GormR/DomesticSupplySupervision/documentation/cutting_PCB.jpg

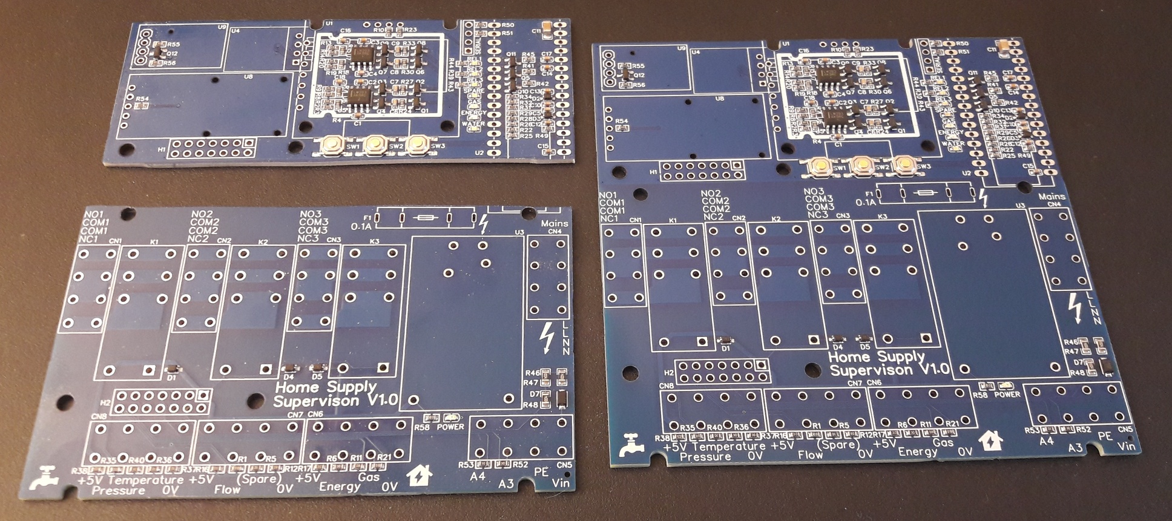
documentation/cutting_PCB.jpg
