GormR/DomesticSupplySupervision/documentation/motor_valve.png

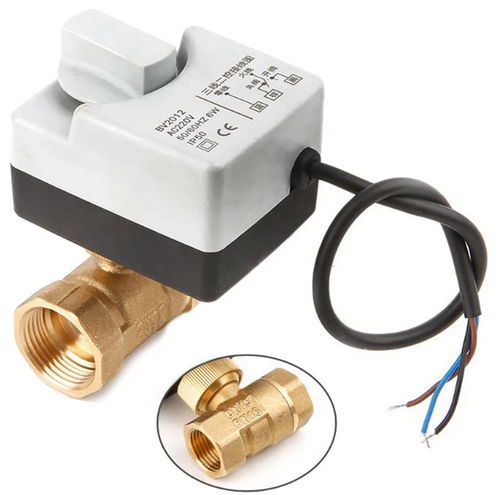
documentation/motor_valve.png
