GormR/DomesticSupplySupervision/documentation/varistor.jpg

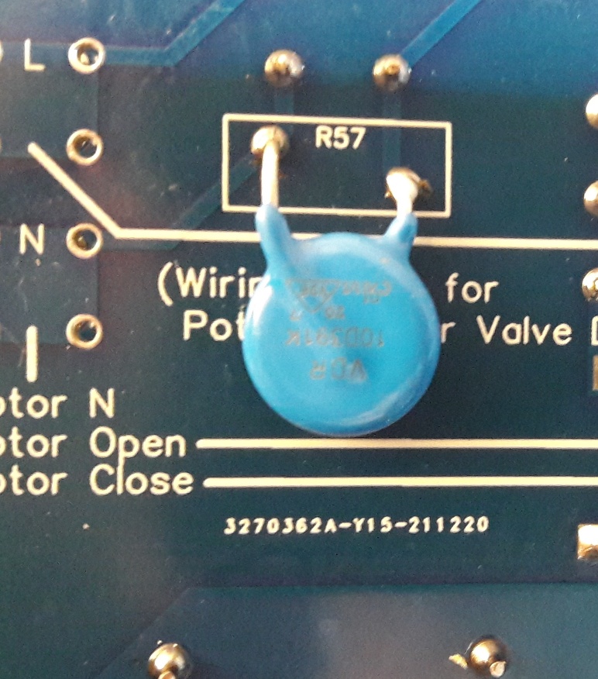
documentation/varistor.jpg
