GormR/DomesticSupplySupervision/documentation/water_flow_meter.png

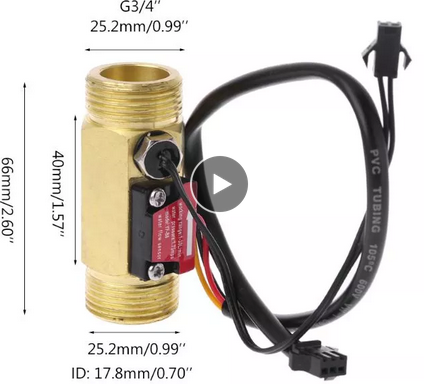
documentation/water_flow_meter.png
