GormR/DomesticSupplySupervision/changelog.txt

V0.0  initial prototype shown in one of the pictures 

V1.0
- first prototype
