GormR/DomesticSupplySupervision/Schematic_Domestic_Supply_Supervision.pdf

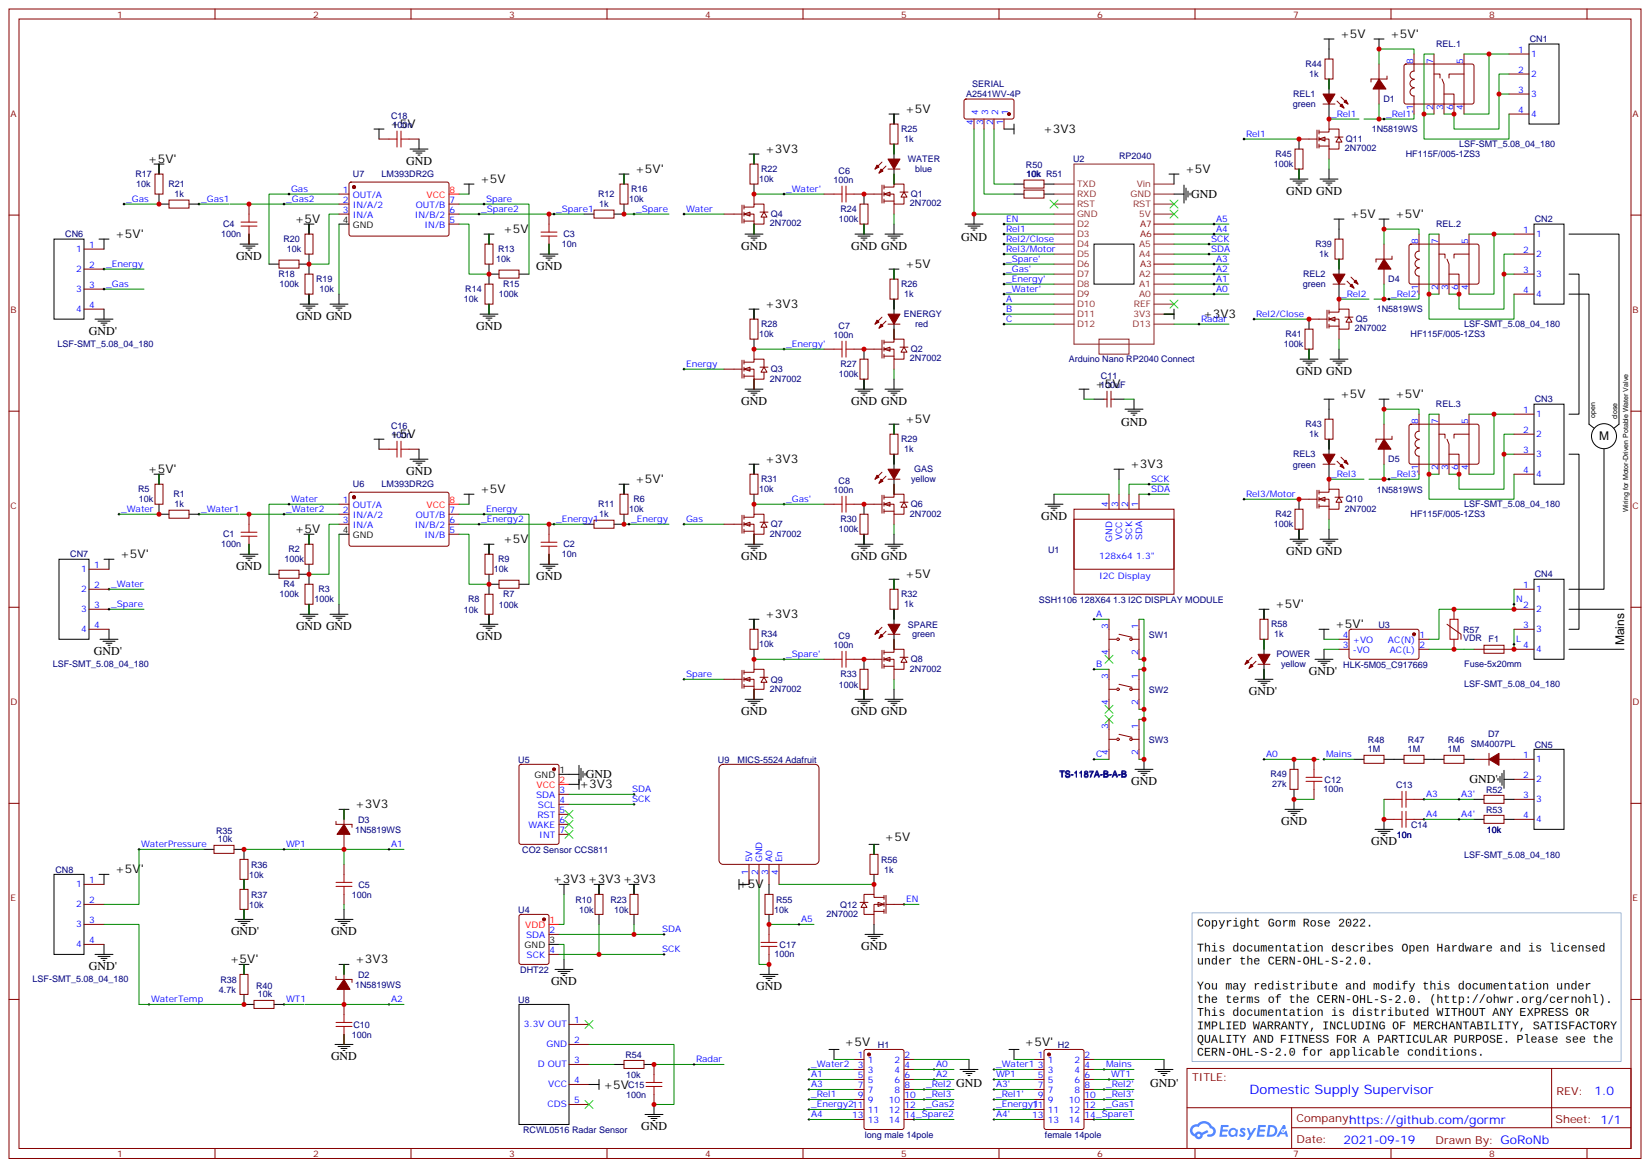
[picture p10: page 1]

Mains Wiring for Motor-Driven Potable Water Valve

Company:https://github.com/gormr
