GormR/DomesticSupplySupervision/PCB_Domestic_Supply_Supervision.pdf

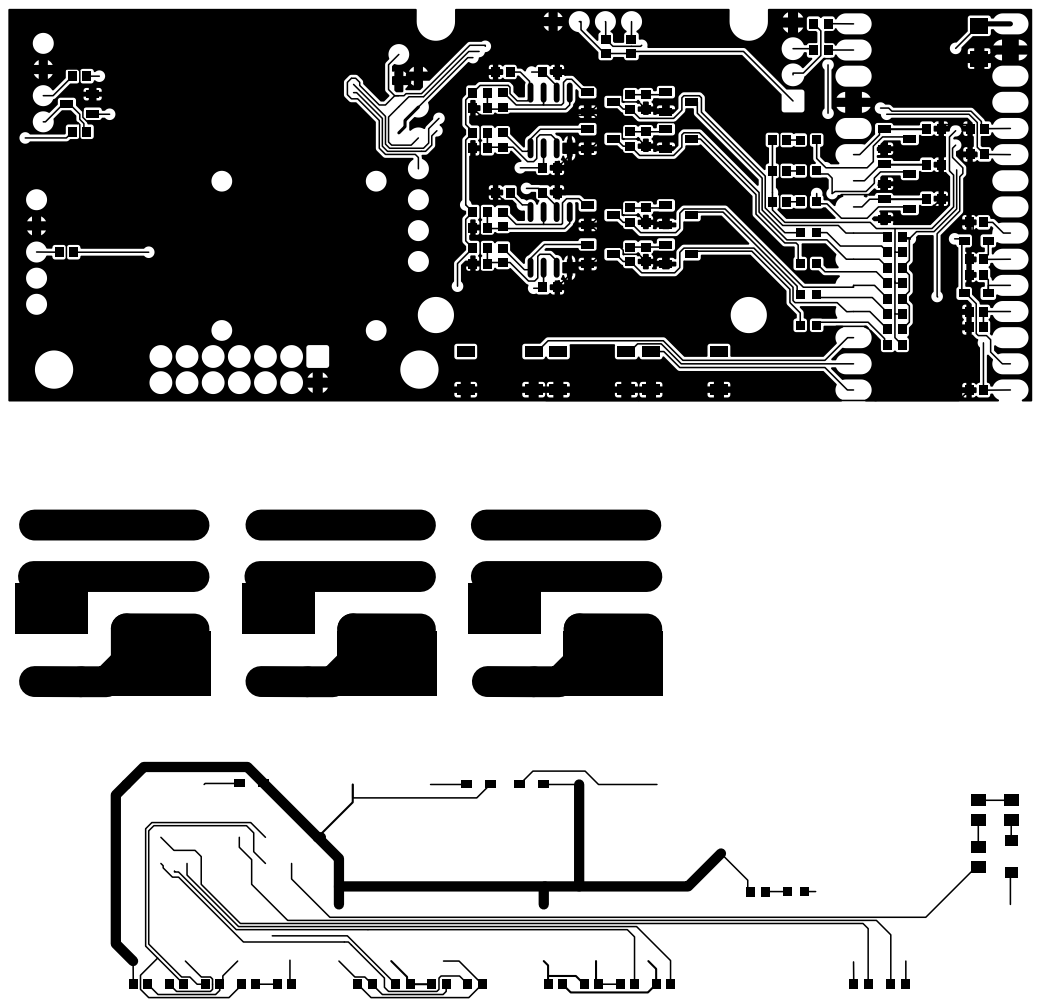
[picture p11: page 1]

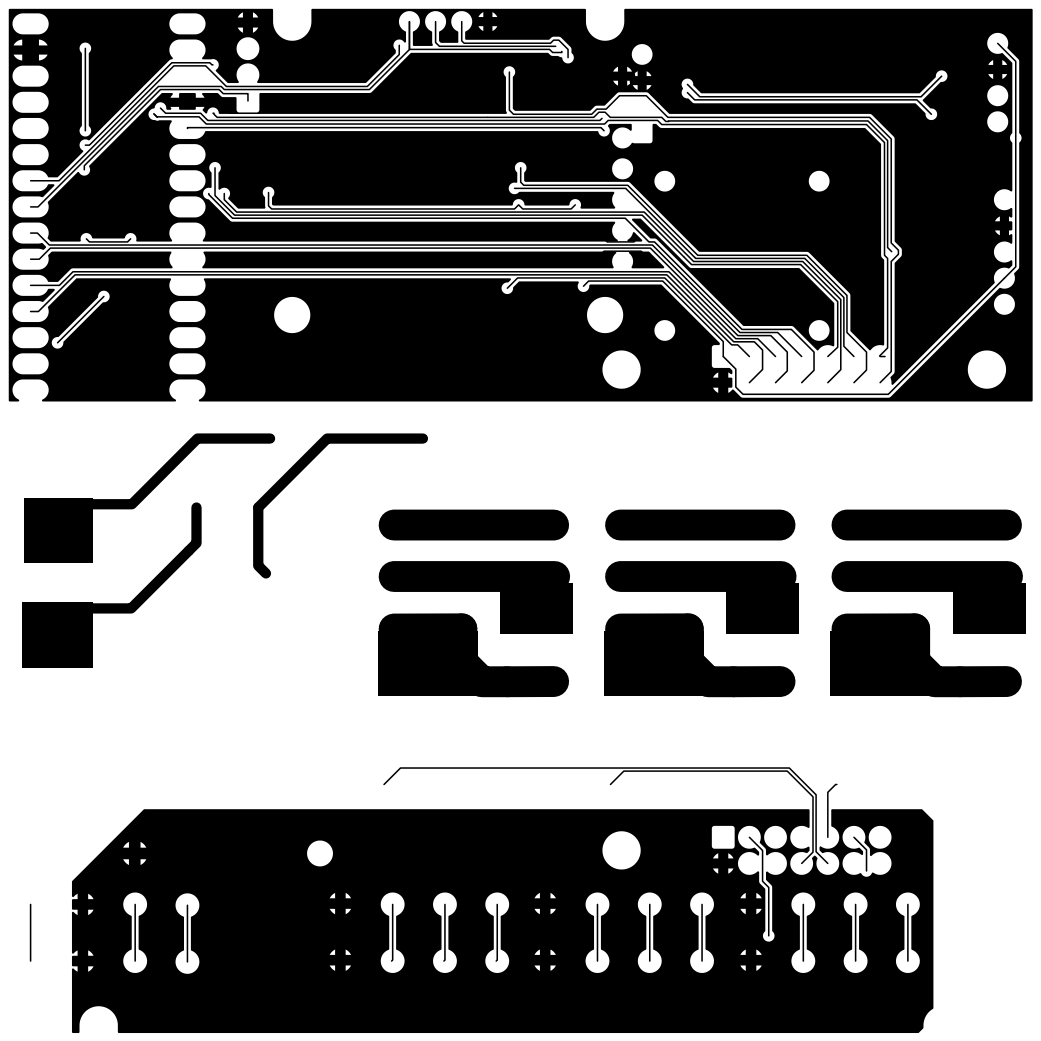
[picture p12: page 2]

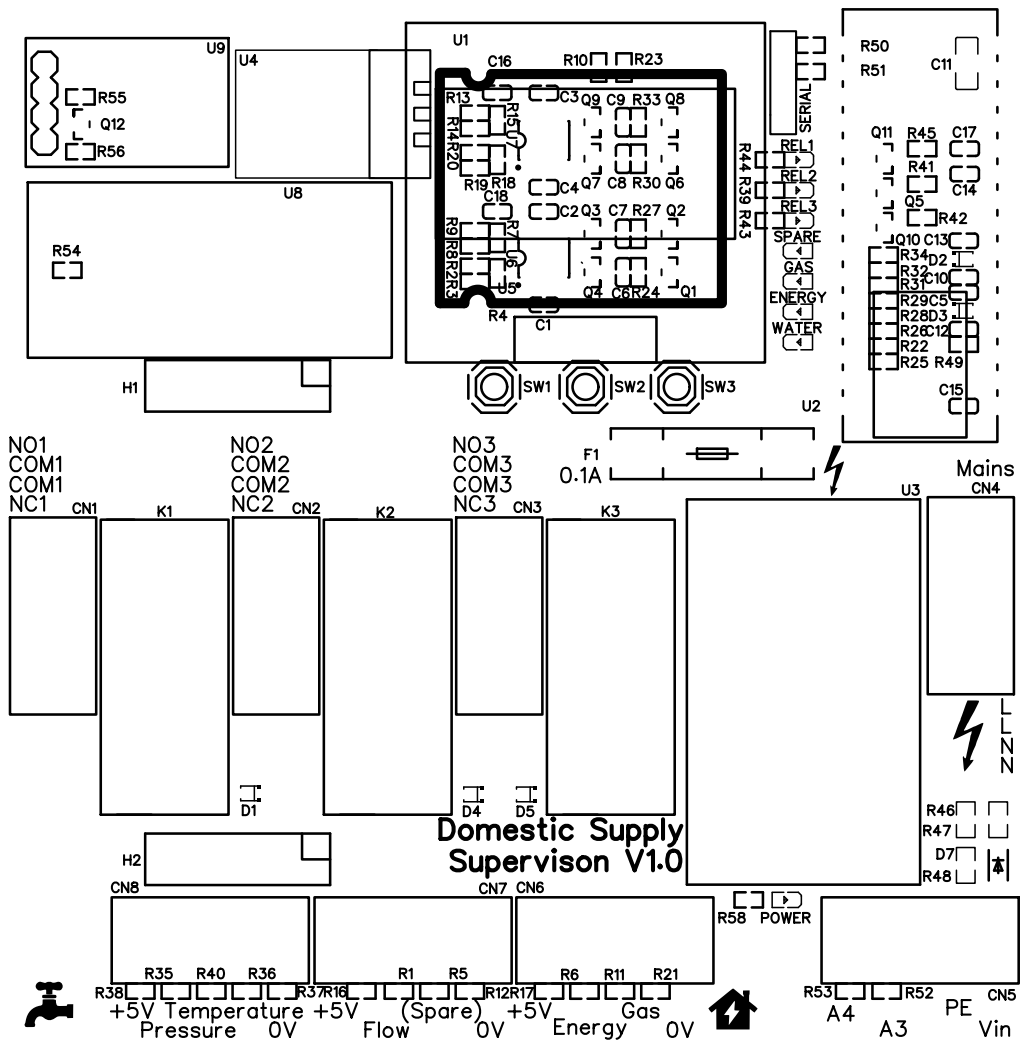
[picture p13: page 3]

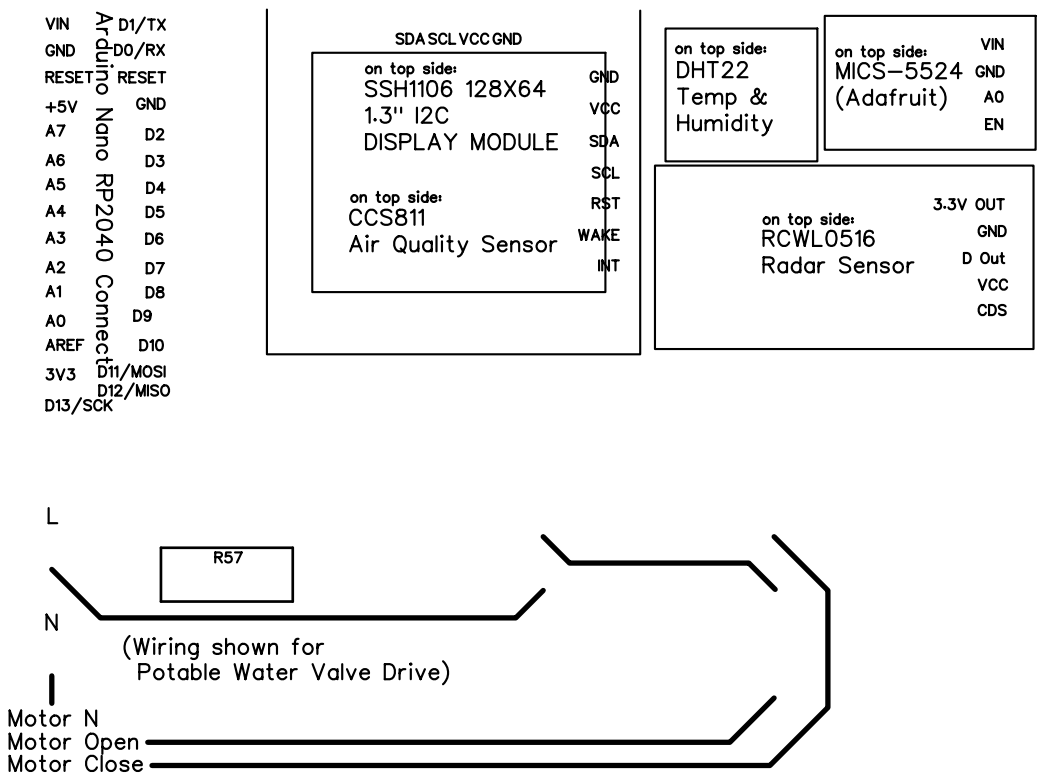
[picture p14: page 4]

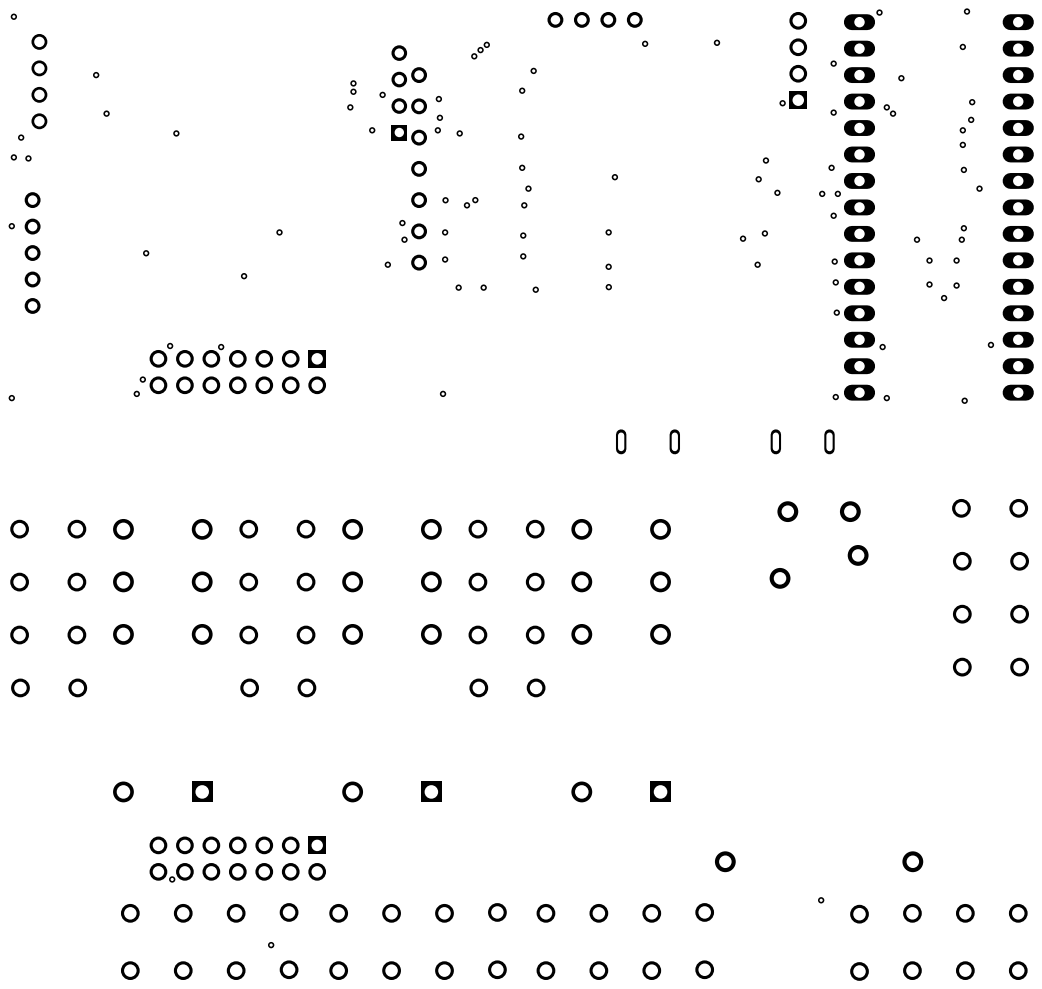
[picture p15: page 6]

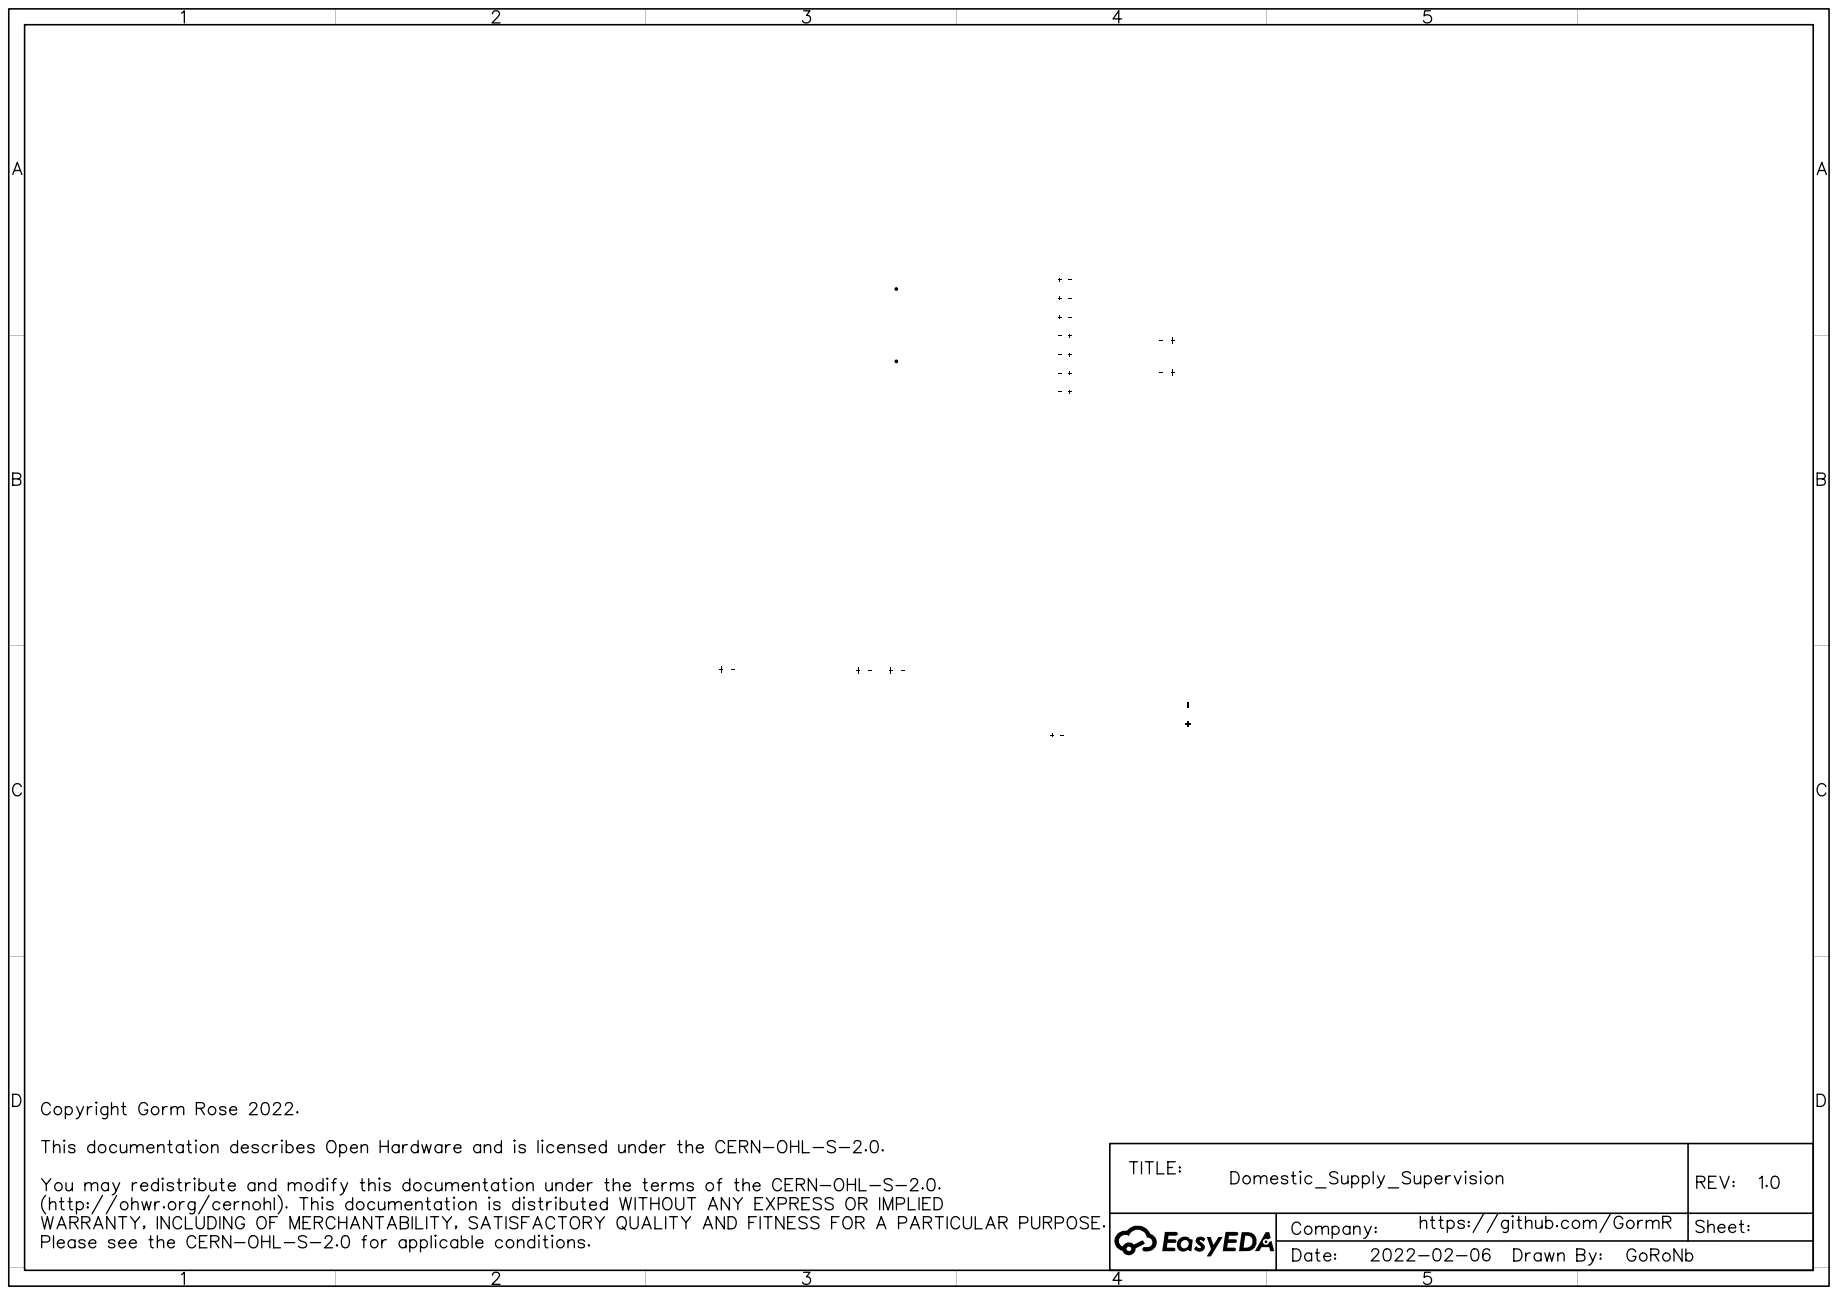
[picture p16: page 7]
