GormR/DomesticSupplySupervision/(list of files, drawings)

Other design files:
EasyEDA_data/PCB_Domestic_Supply_Supervision.json
EasyEDA_data/SCH_Domestic_Supply_Supervision.json
