GormR/DomesticSupplySupervision/(commit log)

2022-01-02 inital commit
    [BOM_Domestic_Supply_Supervision_modified.csv, PCB_Domestic_Supply_Supervision.json, PickAndPlace_PCB_Domestic_Supply_Supervision.csv, SCH_Domestic_Supply_Supervision.json]
2022-02-06 doc and license update to Cern OHL-S-2.0
    [PCB_Domestic_Supply_Supervision.json, SCH_Domestic_Supply_Supervision.json]
